Biomaker/19_Handheld-syringe-pump-with-heating-element/Nicola.jpg

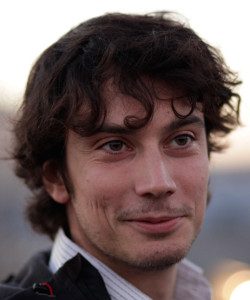
Nicola.jpg
