Biomaker/19_Handheld-syringe-pump-with-heating-element/Cornelius.jpg

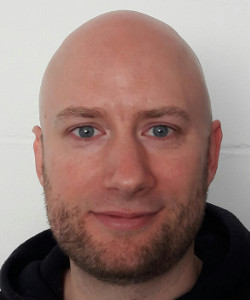
Cornelius.jpg
