Biomaker/19_Handheld-syringe-pump-with-heating-element/Benedikt.jpg

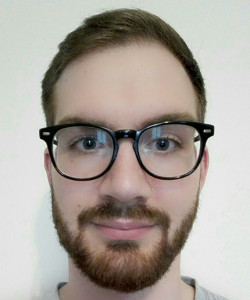
Benedikt.jpg
